mpallewa/PI_UPS/doc/UPS_schem.png

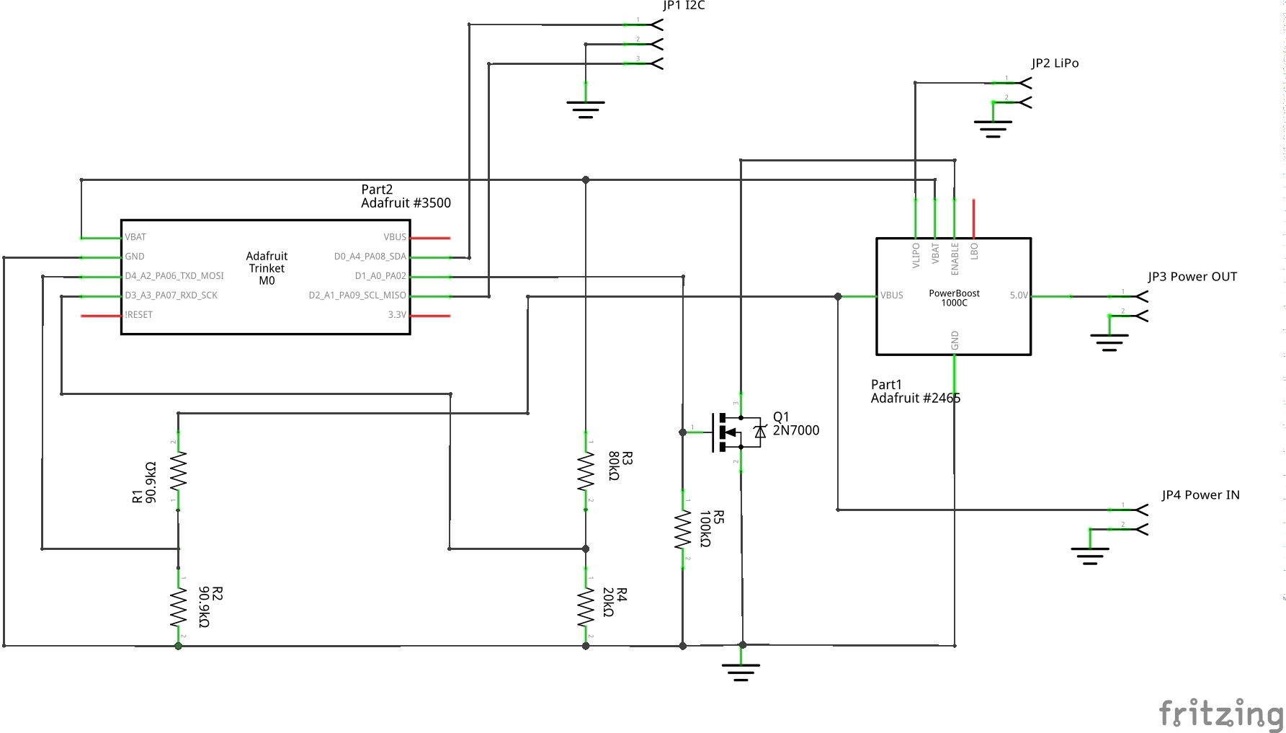
doc/UPS_schem.png
