mpallewa/PI_UPS/doc/VBAT_VEN.png

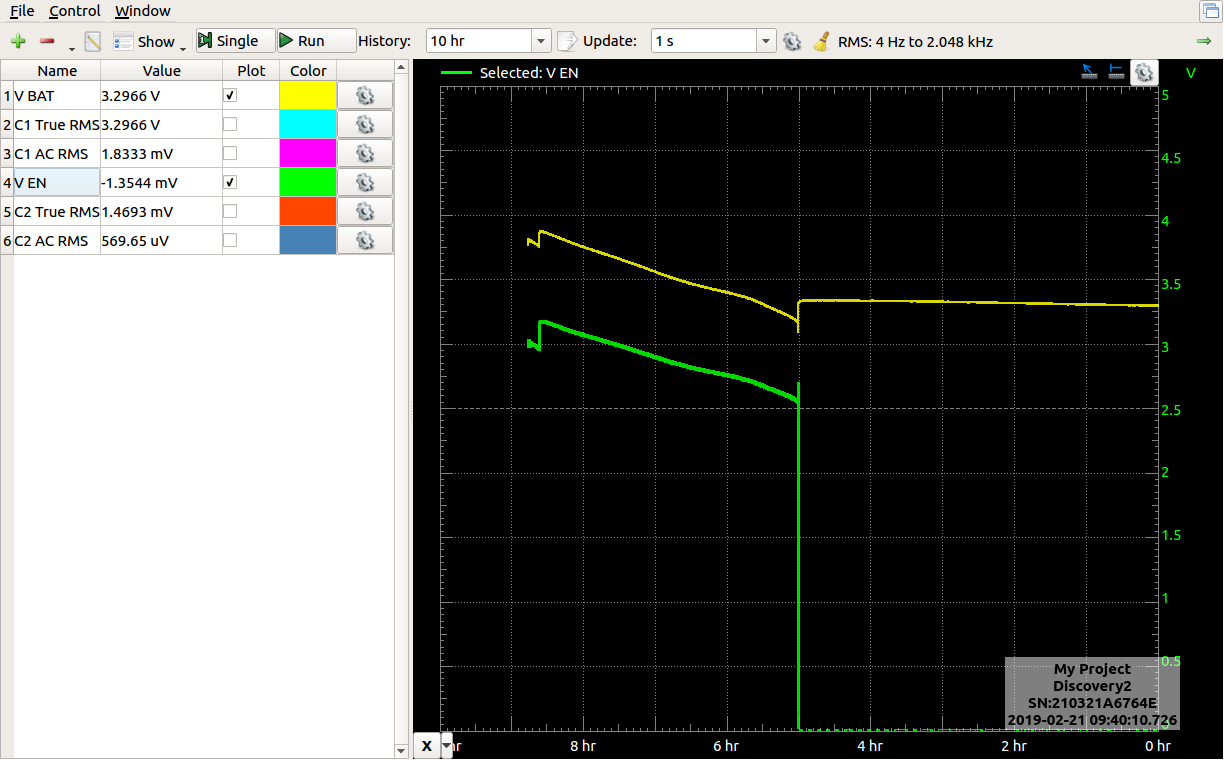
doc/VBAT_VEN.png
