mpallewa/PI_UPS/util/ups.py

#!/usr/bin/python
#
# This code is released under the MIT License.
# 
# Copyright (c) 2019 Methlal Pallewatta
#
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
import smbus
import time
import os
import sys

address = 0x20

pid = os.fork()
if pid!=0:
    sys.exit(0)

bus = smbus.SMBus(1)

while (1):
    read=bus.read_i2c_block_data(0x20,0x00,3)
    if ((read[2] & 0x1) == 1) :
        os.system('shutdown -h now')
    time.sleep(5)
